YUAN-SHEN777/-air-ground-robot/01-simulation/gz-model/airground/meshes/base_collision.stl

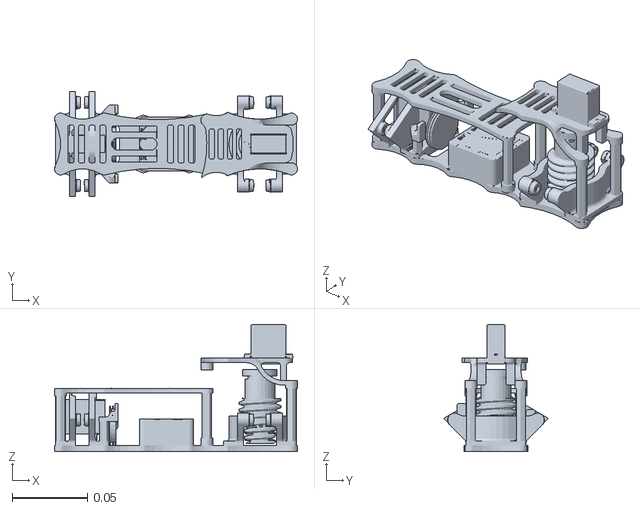
[picture p1: CAD file, 2026-10-28]
01-simulation/gz-model/airground/meshes/base_collision.stl
0.161 x 0.0695 x 0.0844
