YUAN-SHEN777/-air-ground-robot/01-simulation/world/meshes/link7_collision.stl

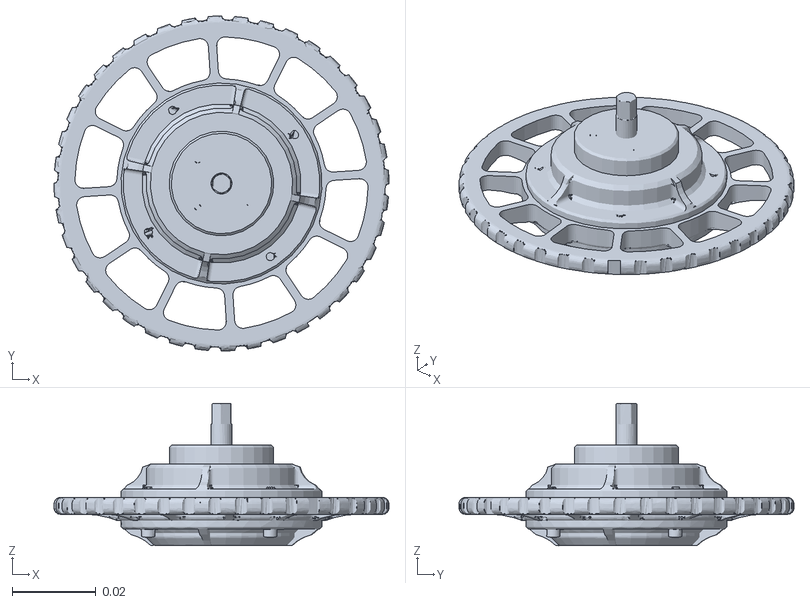
[picture p2: CAD file, 2026-10-28]
01-simulation/world/meshes/link7_collision.stl
0.08 x 0.08 x 0.034
