YUAN-SHEN777/-air-ground-robot/01-simulation/gz-model/airground/meshes/link9_collision.stl

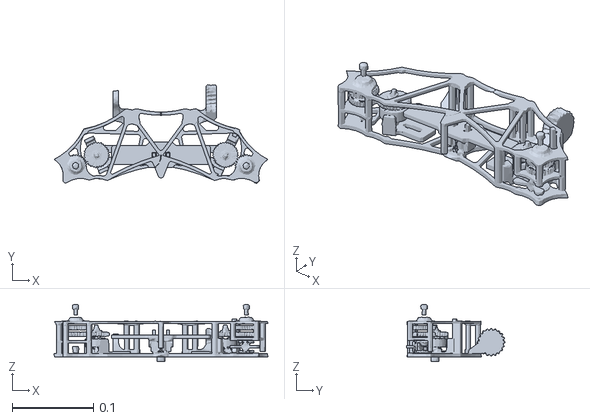
[picture p3: CAD file, 2026-10-28]
01-simulation/gz-model/airground/meshes/link9_collision.stl
0.263 x 0.122 x 0.0707
