YUAN-SHEN777/-air-ground-robot/01-simulation/world/meshes/link1_collision.stl

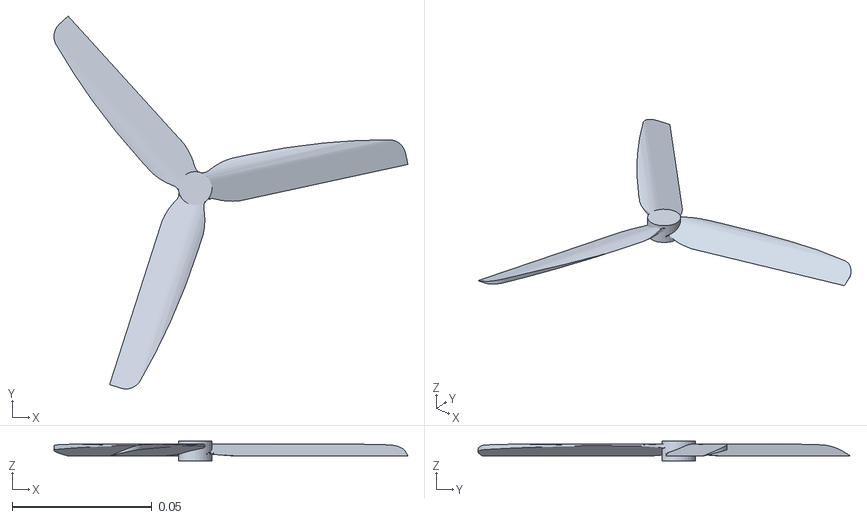
[picture p4: CAD file, 2026-10-28]
01-simulation/world/meshes/link1_collision.stl
0.127 x 0.133 x 0.007
