YUAN-SHEN777/-air-ground-robot/05-px4-modified/files/Tools/simulation/gz/models/airground/meshes/link10_collision.stl

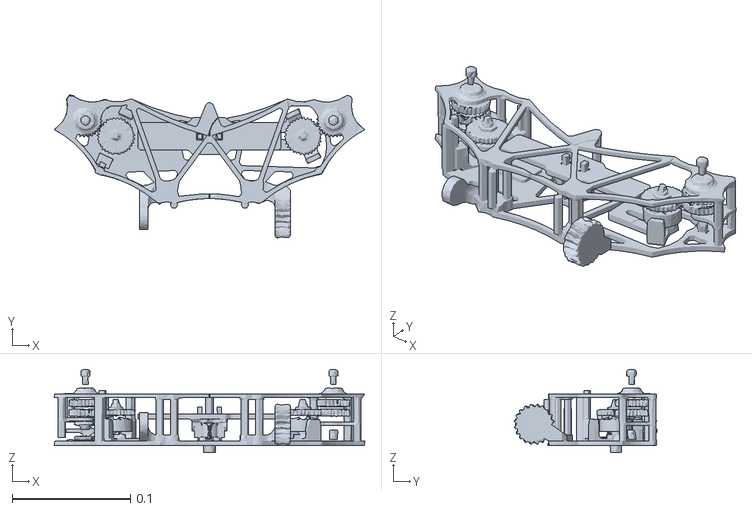
[picture p5: CAD file, 2026-10-28]
05-px4-modified/files/Tools/simulation/gz/models/airground/meshes/link10_collision.stl
0.263 x 0.121 x 0.0705
