YUAN-SHEN777/-air-ground-robot/01-simulation/gz-model/airground/meshes/link2_collision.stl

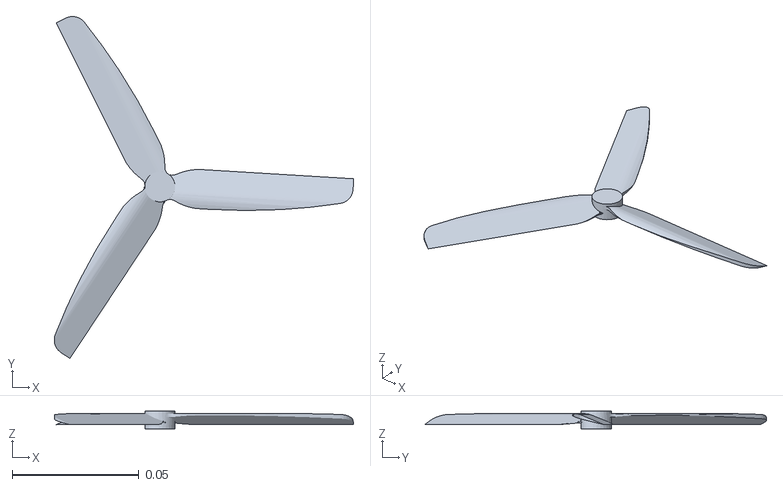
[picture p6: CAD file, 2026-10-28]
01-simulation/gz-model/airground/meshes/link2_collision.stl
0.118 x 0.135 x 0.007
