YUAN-SHEN777/-air-ground-robot/(list of files, cad)

Other CAD files:
01-simulation/world/meshes/link5_collision.stl
01-simulation/gz-model/airground/meshes/link8_collision.stl
01-simulation/gz-model/airground/meshes/link4_collision.stl
05-px4-modified/files/Tools/simulation/gz/models/airground/meshes/link3_collision.stl
01-simulation/world/meshes/link4_collision.stl
05-px4-modified/files/Tools/simulation/gz/models/airground/meshes/link6_collision.stl
01-simulation/world/meshes/link6_collision.stl
05-px4-modified/files/Tools/simulation/gz/models/airground/meshes/link8_collision.stl
01-simulation/world/meshes/link8_collision.stl
05-px4-modified/files/Tools/simulation/gz/models/airground/meshes/link4_collision.stl
01-simulation/gz-model/airground/meshes/link5_collision.stl
01-simulation/world/meshes/link3_collision.stl
01-simulation/gz-model/airground/meshes/link6_collision.stl
01-simulation/gz-model/airground/meshes/link3_collision.stl
05-px4-modified/files/Tools/simulation/gz/models/airground/meshes/link5_collision.stl
