YUAN-SHEN777/-air-ground-robot/04-experiments/README.md

# 实验数据与日志

本目录汇总本项目 **35 项独立实验** 的实测数据与代表性飞行/运行日志。

```
04-experiments/
├── README.md               ← 本文件：实验台账（35 项）
├── data/
│   └── 实验数据汇总.md      ← 全部实测数值（表格化，可直接引用）
└── logs/                   ← 6 份代表性 .ulg 日志
```

> **完整日志集**：本地 `PX4-Autopilot/build/px4_sitl_default/rootfs/log/` 下共 **170 份 / 7.7 GB**（2026-09-27 ~ 10-19）。
> 仓库只收录体积较小的 6 份代表性样本（合计约 11 MB），覆盖舵机整定、地面驱动、转向测试、悬停验证四个阶段。

---

## 一、实验台账

判据说明：每个实验都遵循 **现象 → 假设 → 对照 → 排除 → 判据** 五段式，
下表的"结论/判据"列是可以直接复用的**可验证结论**。

### A 类 · 仿真平台可信度（6 项）

| # | 实验 | 方法 | 关键数据 | 结论 / 判据 |
|:--|:---|:---|:---|:---|
| A1 | 碰撞体代理有效性 | 逐个 link 检查 SDF 构建日志 | 失败 **11 次 → 0 次** | dartsim 不支持 mesh 碰撞体，必须换 primitives |
| A2 | 接触几何精度 | 无控制静置，读 `pose/info` | z = **0.0209996 m**（理论 0.021，误差 **0.4 µm**） | 碰撞/重力/接触链路正确 |
| A3 | 传感器接口契约 | 完整块 vs 精简块 A/B | STALE **4→0**；ARM `TEMP_REJECTED`→**`ACCEPTED`**；电机指令 `[0,0,0,0]`→**`[0.7,1.3,0.7,1.4]`** | 传感器块必须写全 `<imu>`/`<magnetometer>`/`<air_pressure>` 内部配置 |
| A4 | 时间步长敏感性 | 1 ms vs 4 ms × 力矩扫描 | 阈值 **0.48 / 0.80 N·m** | 粗步长通过接触穿透放大阻力（虚高 1.65×）|
| A5 | 实时因子 | 1 ms 世界运行 | RTF = **0.996** | 1 ms 步长几乎无性能代价 |
| A6 | 零负载对照 | `GRAVITY="0 0 0"` | 4 ms 下仍达 **52.00°** | 否证"步长导致控制器失效"（是负载/接触问题）|

### B 类 · 推力模型（5 项）

| # | 实验 | 关键数据 | 结论 / 判据 |
|:--|:---|:---|:---|
| B1 | kT 反推定标 | TWR=3 → kT = **4.325e-7** | `kT = TWR·W/(n·ω_max²)` |
| B2 | 起飞加速度验证 | 实测 **17.76 m/s²** vs 理论 19.62（差 9.5%）| 差值来自一阶惯性上升滞后 |
| B3 | 悬停油门标定 | `MPC_THR_HOVER = 0.5774` | TWR=3 → 悬停油门 ≈ 58% |
| B4 | **四桨转向方向对照** | ccw/cw/cw/ccw → **−23.6 °/s**；**全 ccw → −0.034 °/s**；cw/ccw/ccw/cw → **+23.6 °/s** | `turningDirection` 必须四桨同值（关节轴本身已镜像）；符号自洽验证 |
| B5 | 开环稳定性 | 无姿态控制器 **0.4 s 翻覆** | 多旋翼开环本质不稳（倒立摆），航向实验须把模型吊高 |

### C 类 · 坐标系与布局（3 项）

| # | 实验 | 关键数据 | 结论 / 判据 |
|:--|:---|:---|:---|
| C1 | **y 轴符号镜像** | 修前：0.2 s 内横滚 **38°**、角速度 **481°/s**、翻成肚皮朝天；修后：横滚 **±14°**、悬停 **>10 s** | URDF 用 ENU(y 左)、PX4 用 FRD(y 右) → `CA_ROTORx_PY` 必须取反。**自检判据：改对后 KM 同号的桨落在对角线** |
| C2 | 磁力计链路对照（vs 官方 x500）| 8 个角度，最大偏差 **0.15°** | 我们的磁力计链路与官方模型逐位一致 |
| C3 | ENU→NED 镜像验证 | 每 +45° 实测 −45°，常量 **+92.58°** | "PX4 航向反向变化"是坐标系镜像，不是 Bug |

### D 类 · 舵机执行器（9 项）

| # | 实验 | 关键数据 | 结论 / 判据 |
|:--|:---|:---|:---|
| D1 | 力矩阈值（步长）| 1 ms: **0.48 N·m**；4 ms: **0.80 N·m** | 真机所需 ≈0.48 N·m，0.7 N·m 舵机余量 46% |
| D2 | 空中 vs 地面 | 空中 0.55 s 转 **49.2°**；同舵机在地面卡死 **1.6°** | 阻力 100% 来自地面接触（轮盘平面贴地）|
| D3 | PID 增益扫描 | p/i/d/i_max 多组组合 | 定案 p=5, i=3, d=0.2, i_max=±0.3, cmd_max=±3.0 |
| D4 | **d_gain 极限环（周期-2）** | d=0.5 → 每步 **±0.0786°**、ω=±1.372 rad/s **恒幅不衰减**；d=0.2 → **0.00003°** | 判据 `(Kd+b)·h/J = 2` 为离散稳定边界（本例 ≈0.5）；**100 Hz 采样会混叠成"角度不变"的假象** |
| D5 | **i_max 极限环（积分寻的）** | i_max=0.5 → 抖动 **0.72°**；i_max=0.3 → **0.0003°** | `i_max` 是自激振荡的**振幅天花板**，不是"力气上限"；稳态无抖动优先于静态精度 |
| D6 | 物理阻尼实验 | b=0.5 → 差 **1.4°** 到不了位；b=1.0 → 关节**完全冻死** | "加物理阻尼压超调"这条路**已被实验否决**，只能留 0.2 |
| D7 | 阶跃 vs 斜坡 | 3 s 斜坡 0↔52°：**3.17 / 2.93 s**，超调 **<0.02°** | 斜坡让误差始终很小→积分不饱和→超调消失、上下行对称 |
| D8 | 两臂同步误差 | PX4 端到端：**0.000°**；P4 48% 油门交叉验证：**<0.085°** | 两舵机共用同一功能号 → 物理级同步 |
| D9 | 零位保持 | 静止 25 s 抖动 **0.0014°** | i_max=0.3 已把积分焊死 |

### E 类 · 地面驱动与双向（9 项）★ 核心

| # | 实验 | 关键数据 | 结论 / 判据 |
|:--|:---|:---|:---|
| E1 | **`CA_R_REV` × `KM` 三组对照** | A(REV=15,+−−+): **8 °/s**；B(REV=0,+−−+): **93 °/s**；C(REV=0,−++−): **215 °/s** | `CA_R_REV` 让 PX4 用负推力产生偏航差动，而地面侧输出把桨的负值截断 → 偏航权限被吃掉 |
| E2 | `DIS/MIN/MAX` 值域 | 未解锁误**满速倒车 0.625 m/s**；写 `-1` 被**静默拒绝** | 值域是 `uint16_t [0,1000]`；定案 `DIS=500`（中位=停）|
| E3 | land detector 输入饥饿 | `landed` 恒 false → armed 45 s 后**自动上锁** | 直驱模式下 `mc_rate_control` 不跑 → 必须补发 `vehicle_thrust_setpoint{0}` |
| E4 | 门控自指死锁 | `can_run` 位被清后**永远回不来** | 旧式 `_mode_active ? servo_ok : !armed` 是自指；改为 `(!armed \|\| _landed)` |
| E5 | 直线速度标定 | thr0.4 → **0.240 m/s**（理论 0.240，误差 **0%**）；横向漂移 **0.000 m**；Δyaw **0.00°** | 轮速闭环精确（电机 692/980/641+839 与手算逐位吻合）|
| E6 | 提速验证 | thr1.0 → **1.21 m/s** | `GD_MAX_OMEGA` 是硬限：`v_max = GD_MAX_OMEGA/gear × R`；单独调大 `GD_MAX_SPEED` 无效 |
| E7 | **转向成功率 vs 摆臂角** | 52°:1/6 → 45°:2/6 → 38°:3/6 → 37°:4/6 → **34°:8/8** | 摆臂角降低 → 真实轮距变大 → W/L 改善（W/L<1 是滑移转向的物理天花板）|
| E8 | **转向成功率 vs 轮距** | 0.165:2/10 → 0.22:3/6 → **0.30:8/8** | 轮距 ≥0.30 m（W/L≥1.43）是**唯一根治手段** |
| E9 | **死区宽度 vs 转向可用性** | 死区 ±0.10 → 满舵 mixer 917.5/1082.5 **全落死区，完全无输出**；死区 ±0.015 → **918/1082 正常** | **ESC 死区必须远小于最小控制指令 ±0.0825**（见下方推导）|

### F 类 · 人机接口（3 项）

| # | 实验 | 关键数据 | 结论 / 判据 |
|:--|:---|:---|:---|
| F1 | 摇杆三路对照 | 内核 js0 / SDL2 / QGC 计算 / PX4 实收 逐位比对：pitch 在三路全为中位时 QGC 算出 **+1.000** | QGC v5.0.8 对这台遥控器的轴归一化是坏的，改用 `--rc` + `RC_CHANNELS_OVERRIDE` |
| F2 | 四种控制方式对比 | 310 滑条（免解锁）/ 187 动作（需解锁）/ 脚本 / 407 aux（需解锁+持续发）| 未解锁用 QGC 滑条，已解锁用 QGC 自定义动作按钮 |
| F3 | MAVLink 方言差异 | `ardupilotmega` 的 `MANUAL_CONTROL` **无 aux1~6**；`v10/common` 也没有；**只有 `v20/common` 有** | 需要 aux 字段必须 `from pymavlink.dialects.v20 import common` |

---

## 二、E9 的关键推导（本项目最重要的设计准则）

原地转向不靠 `v_cmd`（`GD_TURN_SLOW=1.0` 时满舵把前进量精确归零），只靠两侧差速：

$$\omega_{cmd} = GD\_YAW\_GAIN \times roll = 1.5 \times 1.0 = 1.5\ \text{rad/s}$$

$$\Delta v = \omega_{cmd} \cdot \frac{W}{2} = 1.5 \times 0.0825 = 0.124\ \text{m/s}$$

$$control = \Delta v \cdot \frac{\text{gear}}{r \cdot \omega_{max}} = 0.124 \times \frac{64}{0.04 \times 2400} = \pm 0.0825$$

换算成 mixer 输出（0..1999，1000 = 中位）：

$$1000 \pm 0.0825 \times 1000 = 917.5 \ /\ 1082.5$$

**打满舵也只有满量程的 8.25%** —— 这是整个系统里**最小的控制指令**。

对比：前后满杆 `control = 1.2 × 0.6667 = 0.80` → mixer **1800**。

> **结论（设计准则）**
> 抑制摇杆回中漂移的职责必须放在**摇杆层**（实测偏置可达 0.12），
> ESC 层死区只承担"真正归零"的兜底，**且必须远小于系统最小控制指令**。
> 两侧死区职责错位，会造成"某个自由度完全失效"的**隐性故障**——
> 表现为前后能动、左右打到底毫无反应。

---

## 三、日志清单

| 文件 | 阶段 | 内容 |
|:---|:---|:---|
| `20261017-040924-hover.ulg` | 悬停验证 | 推力模型接入后的悬停数据 |
| `20261017-041003-hover.ulg` | 悬停验证 | 同上，复测 |
| `20261017-144538-servo-pid.ulg` | 舵机整定 | PID 参数扫描过程 |
| `20261017-145138-servo-ramp.ulg` | 舵机整定 | 指令斜坡 vs 阶跃对比 |
| `20261018-120159-ground-drive.ulg` | 地面驱动 | 直线/差速运动学标定 |
| `20261018-162000-steer-test.ulg` | 转向测试 | 摆臂角 / 轮距对转向成功率的影响 |

**查看方法**：QGroundControl → Analyze → Log Download → Open，或 `PlotJuggler` 加载（需装 ULog 插件）。
