YUAN-SHEN777/-air-ground-robot/04-experiments/data/实验数据汇总.md

# 实验数据汇总

> 全部数值均来自实测（Gazebo 仿真或 Micoair H743 V2 实机），可直接引用到报告。
> 每一项都标注了**理论值/对照值**，便于做误差分析。

---

## 一、仿真平台可信度

| 指标 | 理论 / 对照 | 实测 | 偏差 | 实验号 |
|:---|:---:|:---:|:---:|:---:|
| 碰撞体构建失败次数 | 0 | **0**（原 11） | — | A1 |
| 静置机身高度 | 0.021 m | **0.0209996 m** | **0.4 µm** | A2 |
| STALE 告警次数 | 0 | **0**（原 4） | — | A3 |
| ARM 结果 | `ACCEPTED` | **`ACCEPTED`**（原 `TEMP_REJECTED`）| — | A3 |
| 悬置电机指令 | 非零 | `[0.7, 1.3, 0.7, 1.4]`（原 `[0,0,0,0]`）| — | A3 |
| 舵机力矩阈值 @1 ms | — | **0.48 N·m** | — | A4 |
| 舵机力矩阈值 @4 ms | — | **0.80 N·m** | **+67%**（虚高）| A4 |
| 实时因子 RTF @1 ms | 1.000 | **0.996** | −0.4% | A5 |

## 二、推力模型与悬停

| 指标 | 理论 | 实测 | 偏差 | 实验号 |
|:---|:---:|:---:|:---:|:---:|
| `motorConstant` kT | 4.325e-7 | 反推定标 | — | B1 |
| 满油起飞加速度 | 19.62 m/s² | **17.76 m/s²** | **−9.5%** | B2 |
| 悬停油门 | 0.5774 | 0.5774 | 0% | B3 |
| 悬停高度 | 目标恒定 | **2.0 ~ 2.55 m**，波动 **±0.04 m** | — | B3 |
| 悬停水平漂移（27 s）| 0 | **< 7 cm** | — | B3 |
| 悬停姿态波动 | 0 | 横滚 **±0.3°**、俯仰 **±0.2°** | — | B3 |
| 悬停偏航变化（27 s）| 0 | **0.3°** | — | B3 |
| 满油离地高度 | — | **1.27 m** | — | B2 |
| 关桨回落高度 | 0.021 m | **0.021 m** | 0 | B2 |

### 四桨转向力矩（`turningDirection` 对照）

| 配置 | 平均偏航角速度 | 偏航摆幅 |
|:---|:---:|:---:|
| `ccw/cw/cw/ccw`（对角配对，**错**）| **−23.6 °/s** | 3.95° |
| **`ccw/ccw/ccw/ccw`（四桨同值，对）** | **−0.034 °/s** | **0.005°** |
| `cw/ccw/ccw/cw`（符号反转，验证用）| **+23.6 °/s** | — |

> 改善约 **700 倍**；符号反转自洽，证明结论可靠。

## 三、坐标系与布局

| 指标 | 修前 | 修后 |
|:---|:---:|:---:|
| 起飞稳定时间 | 0.2 s 内翻覆 | 平稳爬升 |
| 悬停高度 | 0.084 m（躺地）| **2.0 ~ 2.55 m** |
| 横滚幅度 | ±180° | **±14°** |
| 俯仰幅度 | ±85° | **±13°** |
| 连续悬停时长 | 0 | **> 10 s** |

### 磁力计链路对照（vs 官方 `gz_x500`）

| 真实偏航（ENU）| x500 | airground | 偏差 |
|:---:|:---:|:---:|:---:|
| 0° | +92.56° | +92.58° | 0.02° |
| 45° | +47.71° | +47.56° | 0.15° |
| 90° | +2.57° | +2.60° | 0.03° |
| 180° | −87.44° | −87.51° | 0.07° |
| 315° | +137.56° | +137.56° | 0.00° |

## 四、摆臂舵机

| 指标 | 值 | 备注 |
|:---|:---:|:---|
| 摆臂到位角 | **52.00°** | 指令 +1.0 |
| 两臂同步误差 | **0.000°** | 同一功能号 |
| 两臂同步误差（48% 油门）| **< 0.085°** | 交叉验证 |
| 上升时间（0→52°）| **3.17 s** | 3 s 斜坡 |
| 下降时间（52→0°）| **2.93 s** | 3 s 斜坡 |
| 超调 | **< 0.02°** | 斜坡方案 |
| 静止抖动（25 s）| **0.0014°** | i_max=0.3 |
| 空中响应（0.7 N·m）| 0.55 s 由 1.6° → **49.2°** | 自由落体测试 |
| 地面卡死角 | **1.6°** | 同舵机，接触阻力 |

### 两个极限环

| 现象 | 参数 | 结果 |
|:---|:---|:---|
| 周期-2 极限环 | `d_gain = 0.5` | 每步翻转 **±0.0786°**，ω=±1.372 rad/s，**恒幅不衰减** |
| 同上 | `d_gain = 0.2` | **0.00003°** |
| 积分寻的 | `i_max = 0.5` | 抖动 **0.72°** |
| 同上 | `i_max = 0.3` | 抖动 **0.0003°** |
| 物理阻尼 | `damping = 0.5` | 到不了位，差 **1.4°** |
| 同上 | `damping = 1.0` | 关节**完全冻死**（读数 0）|

**摆臂角 → 机身高度**（触地联锁判据依据）

| 摆臂角 | 机身 z |
|:---:|:---:|
| 0° | 0.0210 m |
| 26° | 0.0624 m |
| 38° | 0.0876 m |
| 52° | 0.1014 m |

## 五、地面驱动

### 直线

| 油门 | 理论速度 | 实测速度 | 偏差 | 电机量 | 横向漂移 | Δyaw |
|:---:|:---:|:---:|:---:|:---:|:---:|:---:|
| 0.4 | 0.240 m/s | **0.240 m/s** | **0%** | 692 / 980 | **0.000 m** | **0.00°** |
| 1.0 | 1.200 m/s | **1.21 m/s** | +0.8% | 900 | — | — |

> 轮关节实测角速度与指令偏差 **< 1%**；轮速闭环精确。

### 转向（滑移转向偏航权限）

**摆臂角扫描**（纯 pivot 3 s，|Δψ| > 10° 记为成功）

| 摆臂角 | 真实轮距 | W/L | 成功率 | 平均 Δψ |
|:---:|:---:|:---:|:---:|:---:|
| 52°（原设计）| 0.1282 m | 0.611 | 1/6 | 小 |
| 45° | 0.1462 m | 0.696 | 2/6 | — |
| 38° | 0.1629 m | 0.776 | 3/6 | — |
| 37° | 0.1657 m | 0.789 | 4/6 | — |
| **36°** | 0.1684 m | 0.802 | **6/6** | — |
| **35°** | 0.1698 m | 0.809 | **6/6** | **107.8°** |
| **34°** | 0.1717 m | 0.817 | **8/8** | **117.3°** |
| 30° / 26° | 0.1799 m | 0.857 | 0/6 | **轮子悬空** |

**轮距扫描**

| 轮距 | 成功率 |
|:---:|:---:|
| 0.165 m | 2/10 (20%) |
| 0.22 m | 3/6 (50%) |
| **0.30 m** | **8/8 (100%)**，3 s 转 136~150°，σ=5.6° |

> ⚠️ W/L < 1 是滑移转向的物理天花板；`GD_YAW_GAIN` 从 1.5 提到 5.0 只把成功率从 20% 拉到 40%。

### 偏航权限 vs `CA_R_REV` / `KM`

| 配置 | 右偏航 | 左偏航 | 偏航峰值 |
|:---|:---:|:---:|:---:|
| A：`CA_R_REV=15`，`KM=(+−−+)` | +2 °/s | +3 °/s（反） | **8 °/s** |
| B：`CA_R_REV=0`，`KM=(+−−+)` | −16 °/s（反） | +28 °/s | **93 °/s** |
| C：`CA_R_REV=0`，`KM=(−++−)` | +23 °/s ✅ | +27 °/s | **215 °/s** |

### DShot 3D 死区（E9）

| 死区设置 | 满舵转向 mixer 输出 | 结果 |
|:---|:---:|:---|
| 900 ~ 1100（±0.10）| 917.5 / 1082.5 | ❌ 全落死区 → **左右完全无输出** |
| **985 ~ 1015（±0.015）** | **918 / 1082** | ✅ 正常 |

## 六、关键换算常数

| 量 | 值 |
|:---|:---|
| 换算系数 `k = gear/(r·ω_max)` | **0.6667** (1/(m/s)) |
| 半轮距 `W/2` | **0.0825 m** |
| 原地转向 `control`（满舵）| **±0.0825** |
| 原地转向 mixer 输出 | **917.5 / 1082.5** |
| 前进满杆 `control` | **0.80** |
| 前进满杆 mixer 输出 | **1800** |
| 轮子顶速 `ω_max/gear·r` | **1.50 m/s** |

## 七、实机平台参数

| 项 | 值 |
|:---|:---|
| 飞控 | MicoAir H743 V2（STM32H743VIT6）|
| 传感器 | BMI088 + BMI270 + SPL06 + QMC5883L（rotation 4）|
| 输出通道 | 10（`DIRECT_PWM_OUTPUT_CHANNELS`）|
| 电机输出 1~4 | TIM1 CH4/3/2/1 → PE14 / PE13 / PE11 / PE9 |
| 舵机输出 9~10 | TIM15 CH1/2 → PE5 / PE6（无 DMA → 不可 DShot）|
| 电调 | AM32 4-in-1 55A（AT32F421，F4A_4IN1_F421 v2.19）|
| 电调参数 | Servo Low 1006 / High 2006 / Neutral 1502，KV 2220，14 极，3D mode |
| 固件 | PX4 v1.18.0-beta1 自编译 |
| FLASH 占用 | **1,898,664 B / 1,920 KB = 96.57%** |
| 电机协议 | DShot300（`PWM_MAIN_TIM0 = -4`）|
