YUAN-SHEN777/-air-ground-robot/(commit log)

2026-10-28 陆空两栖机器人控制方法与系统实现
    - 仿真平台：四层保真度体系（几何/接触/执行器/传感器）+ 可信度验证
    - 控制方法：ground_drive 外部模式（1301 行）+ AirGroundMux 插件（2033 行）
    - 电机双向驱动：DShot 3D 协议 / 分配 / 编码 / 门限 四层矛盾与定案
    - 实机移植：MicoAir H743 V2 + AM32 4-in-1（3D mode）
    - 实验：35 项独立实验，6 份代表性日志
    - 文档：6 份技术文档（5713 行 / 213 个三级小节）
    [airground.sdf, base_collision.stl, link10_collision.stl, link1_collision.stl, link2_collision.stl, link3_collision.stl, link4_collision.stl, link5_collision.stl]
2026-10-28 docs: 精简 README 为正式文档体例
    - 删除「三个反直觉结论」与「工作量统计」两节
    - 移除行数/实验计数等展示性表述
    - 章节重新编号（一~八）
2026-11-01 同步 9/10 路门控、双向驱动与仿真模型的最新代码
    [model.sdf, mux_unit.sdf]
